Chiragadiga/Motion_Estimator_28nm/README.md

# Motion_Estimator_28nm
Design of RTL to GDS2 layout for ME with 15 FPS for 8 bit gray-scale coded pictures with Reference block of 16X16 px and search window of 32X32 px
