Chiragadiga/Motion_Estimator_28nm/readme.txt

You can find Attached the reports of the Design, Simulation, Physical Design in this folder

The clock period id 3.846 ns which is 1/260 Mega Hertz

All reports were added in the 'Reports' file but not in the project report and presentation  (Kindly consider)
 
The stimuli is in the .hex format

Physical Design in icc2 is conducted by creating a TOOL COMMAND LANGUAGE(tcl) file and are sourced with the required files
