Chiragadiga/Motion_Estimator_28nm/ENGR_852_Chirag.docx

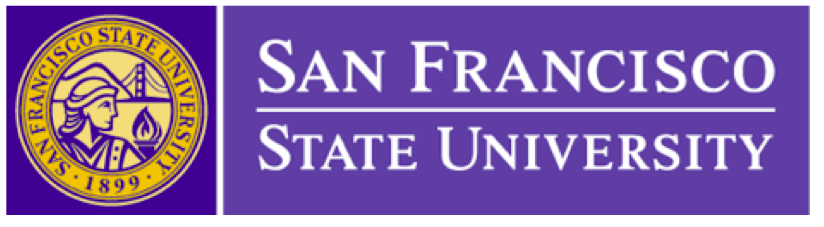
[picture p4: figure]

Final Project Report

on

ASIC Implementation of Motion Estimator in 32/28nm CMOS

Guided by Prof. Hamid Mahmoodi

Advanced Digital Design

Fall 2021

By:

Chirag C Adiga (922059109)

ACKNOWLEDGEMENT

Finishing the semester with this project report is an appropriate opportunity to express our gratitude to Dr. Hamid Mahmoodi for his invaluable guidance & support.

Without his incredible inputs, patience, excellent guidance and motivation at each and every step of the project we could not have completed this project.

A token of appreciation towards Lovpreet our teaching assistant who helped us at multiple occasions when we were confused about implementing the various concepts.

We are immensely grateful to our friends and classmates. They have supported and guided us at various stops and faults during the project.

Table of Contents

1. Understanding the Motion Estimator............................................................4
2. Design Specifications.....................................................................................6
3. Testbench for RTL verification......................................................................7
4. DC Synthesis................................................................................................11
5. Pre-Layout Timing Verification using Prime Time…….…………………18
6. Physical Design............................................................................................19
  a) Floor planning
  b) Placement
  c) Clock tree synthesis
  d) Routing
  e) Extraction
7. Post-Layout Timing Verification using Prime Time……..………….…….29
8. Results……………………………………………………………………..32
9. References…………………………………………………………………33

1. What is Motion Estimator

Motion estimation is the process of determining motion vectors that describe the transformation from one 2D image to another, usually from adjacent frames in a video sequence. Motion estimation is one of the key components of high compression video CODECS. The motion vectors may relate to the whole image (global motion estimation) or specific parts, such as rectangular blocks, arbitrary shaped patches or even per pixel (https://en.wikipedia.org/wiki/Pixel). The motion vectors may be represented by a translational model or many other models that can approximate the motion of a real video camera, such as rotation and translation in all three dimensions and zoom.

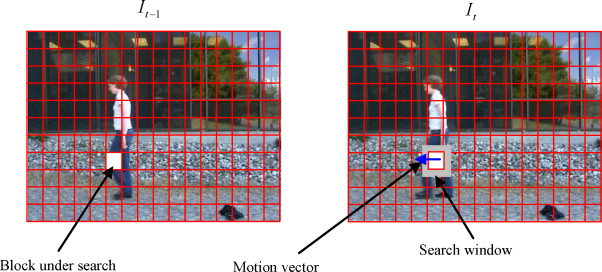
[picture p5: figure]

Fig 1: Concept of Motion Estimator

Figure 1 shows the concept of Motion Estimator, it illustrates a process of block-match algorithm. The most popular algorithm for motion estimation is block matching algorithm (BMA) due to simple hardware implementation. In a typical BMA, each frame is divided into blocks, each of which consists of luminance and chrominance blocks. Usually, for coding efficiency, motion estimation is performed only on the luminance block. The motion vector and the resulting error can be transmitted instead of the original luminance block; thus, interframe redundancy is removed and data compression is achieved. At receiver end, the decoder builds the frame difference signal from the received data and adds it to the reconstructed reference frames. The summation gives an exact replica of the current frame. The better the prediction the smaller the error signal and hence the transmission bit rate.

2.Design Specifications

The goal of the design is to achieve the following specifications:

- The design is expected to meet the speed of 15 frames per second.
- The picture is gray-scale coded (8 bits per block).
- The reference block is 16x16 pixels and the search window is 32x32 pixels. There are 4096 reference blocks in a frame.
- To minimize the total area and energy consumed by the logic over the entire simulation of the test set.
- Must operate at the speed given above.

Verification Plan:

Several test benches will be developed with known motion vectors as well as random stimulus. These test benches will be applied to the design and the results will be compared against expected outcomes. The expected outcomes will be produced using a reference model or manually and compared against the outcomes produced by the design under test.

Design Plan:

After verification of the RTL code, the design is taken to the ASIC flow starting with front-end synthesis and timing check, followed by back-end physical design involving placement, clock-tree synthesis, and routing. The parasitics will be extracted from layout for final timing check using primetime. Efforts will be made to improve the design in terms of power consumption and area, while meeting the timing.

3. Test Bench Verification

Test bench provides the top-level design that stimulus the design. It is an environment in which the product under development is tested with the help of software and hardware tools. Individual modules were verified first by separate testbenches. Then a to-level test bench was implemented to verify the overall functioning of the complete design.

Verification scripts

source /packages/synopsys/setup/synopsys_setup.tcl

Verification of Processing Element module: Arbitrary inputs were assigned within the testbench to inputs and observe the generated outputs. The idea was to verify the logical functioning of the S1S2mux signal such that it selects value S2 rather than S1 on active high signal. Also, arithmetic correctness of the accumulate signal is verified through waveforms.

- For PE verification:

vcs –V –R –full64 PE_tb.v PE.v –debug_pp –o simv –gui

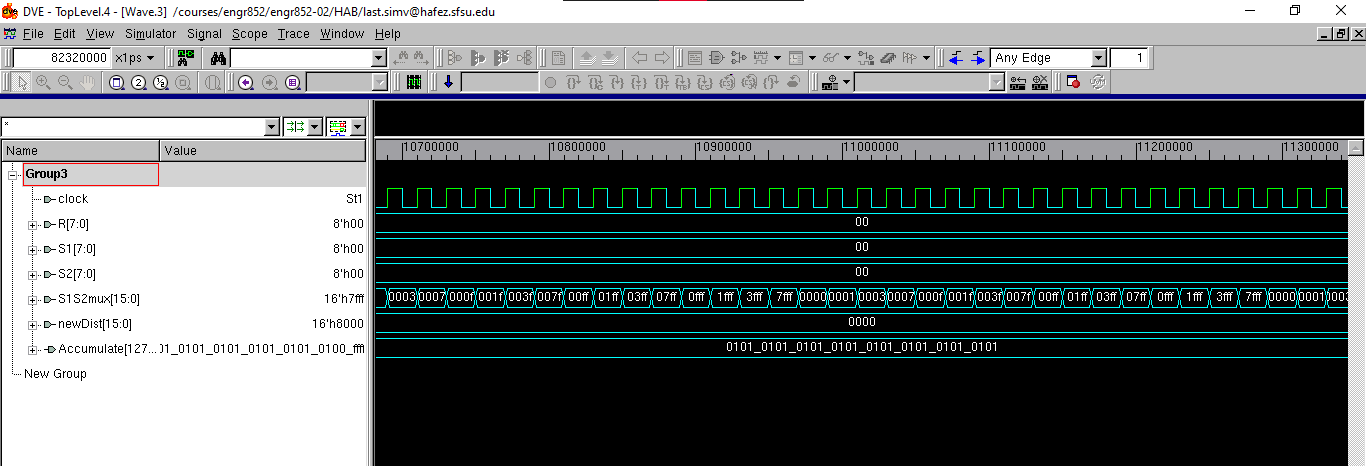
[picture p6: figure]

Fig 2: Simulation Results of Processing Element

Verification of Control Unit: The control implemented a counter to generate control signals and the value of these signals were dependent on count register of the control unit. The testbench simply initializes the control unit through a start signal and then monitors the generated signals. The generated signals were observed in the waveforms and the values for all the control signals were as desired.

- For control module verification:

vcs –V –R –full64 ctrl_tb.v control.v –debug_pp –o simv –gui

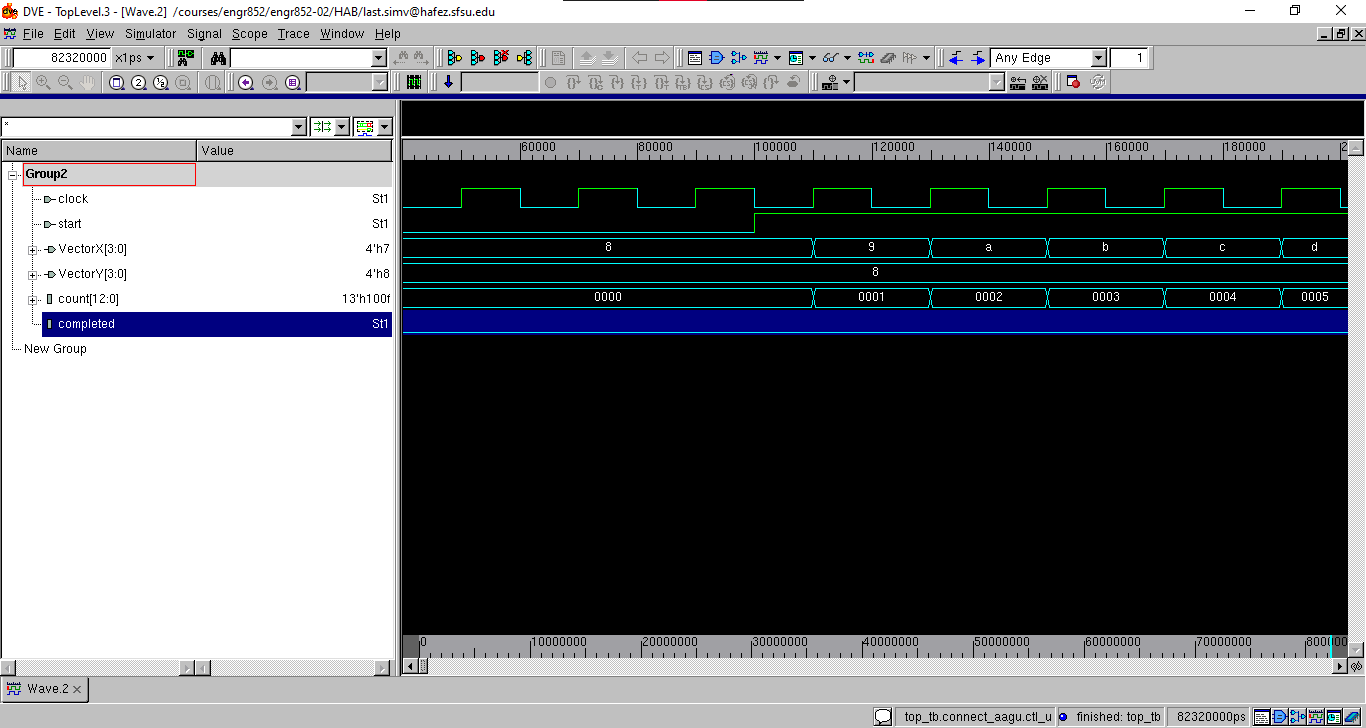
[picture p7: figure]

Fig 3: Simulation Results of Control Unit

Verification of Comparator Unit: The testbench loads PEout register is loaded with and arbitrary value and then random PEready signals, VectorX, VectorY values are applied by testbench to imitate an input of the PE and Control unit. The idea is to observe the BestDist values and Motion vectors are generated as desired from these input vectors. The values observed in waveforms verified the logical functioning of the comparator unit as the intended values were recorded.

- For comparator module verification:

vcs –V –R –full64 comp_tb.v comp.v –debug_pp –o simv –gui


Fig 4: Simulation Results of Comparator

Verification of top level testbench:

Top test bench is connected to the top module of RTL and is providing the Reference and Search values to the RTL by reading external .txt files. The first reference value is set to ‘1’ and all other values are set to 0 while search values are all set to ‘0’. The intention is to produce a distortion for initial values which the comparator will output as best distortion value once the CompStart signal goes high and updates the motionX and motionY values as (-8,8).

Since the distortion occurs at first value, the reference window will be at the top left corner of the search window, so the motion for X= -8 and Y =8 should be observed in waveforms. The observed values of motionX in waveforms is 8 and it is a 2’s complement value of (-8). The initial VectorX values from the control RTL are 2’s complement of (-8, -7, -6, -5, -4, -3, -2, -1) as (8, 9, a, b, c, d, e, f, ) when compared with the VectorX expression in control RTL ( these values can be observed in control unit testbench waveforms while verification of control module). Since the motionX value is directly latched from the values of VectorX within the comparator, it verifies the motionX value ‘8’ in waveforms is a 2’s complement of ‘-8’.

The intended values for motion vectors were observed as outputs to verify that the design generates correct motion values for the least distortion observed during overlays.

- For top level verification:

vcs –V –R –full64 top_tb.v rtl.v –debug_pp –o simv –gui


Fig 5: Simulation Results of Top Level Test bench

# 4. DC Synthesis

Design Compiler is a synthesis tool that synthesizes RTL [Register Transfer Logic] hardware description (Verilog/VHDL) which has a standard cell of library as input which provides output of a gate-level-netlist. Gate-level-netlist is a structural representation of standard cells based in the standard cell library.

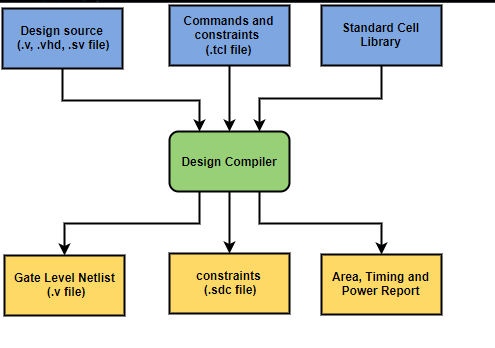
[picture p8: figure]

Fig 6: Synthesis Flow

The design on synthesis gave a negative slack for set-up time approx. 3.04 in magnitude. The issue was significant since the value was almost equal to clock frequency. The issue was resolved by using LVT cells for the design working in ff (fast-fast) configuration. The post synthesis set-up time was reported with a slack of 2.95 after the implementation of LVT cells in the design.

Synthesis scripts

dc_shell –xg –t

lappend search_path path of RTL

define_design_lib WORK –path “work”

source ../../../../lib_setup.tcl

options selected [yes (multi-threshold design), ccs, lvt, ff]

source …/…/…/../lib_container.tcl

analyze –library WORK –format Verilog rtl.v

elaborate –architecture Verilog –library WORK Switch

create_clock clock –name ideal_clock1 –period 3.846

compile –incremental

write_sdc estimator.sdc

write –f ddc –hierarchy –output estimator.ddc

report_area > reports/estimator_area.rpt

report_cell > reports/estimator_cell.rpt

report_design > reports/estimator_design.rpt

report_power > reports/estimator_synthesis_power.rpt

report_timing > reports/estimator_synthesis_timing.rpt

report_timing –delay min > reports/estimator_synthesis_hold.rpt

DC synthesis Timing Report:

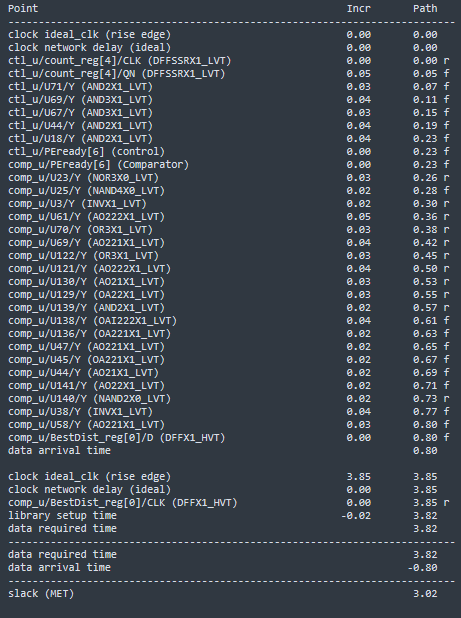
[picture p9: figure]

Fig 7 : Maximum Timing Report ( Post Synthesis)

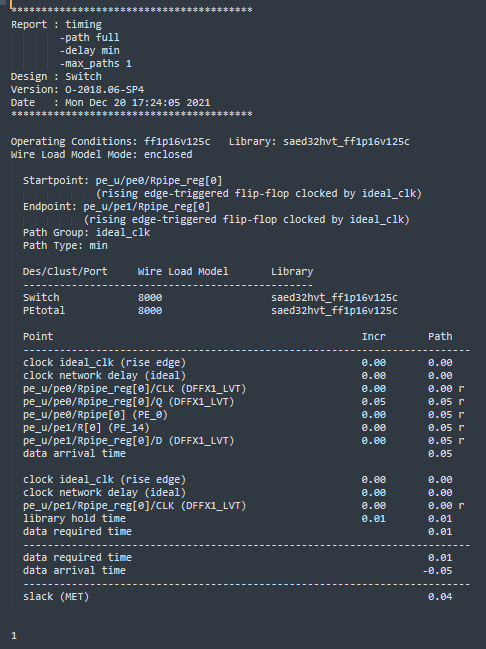
[picture p10: figure]

Fig 8: Minimum Timing Slack Report ( Post Synthesis)

Reports of Area Post Synthesis:

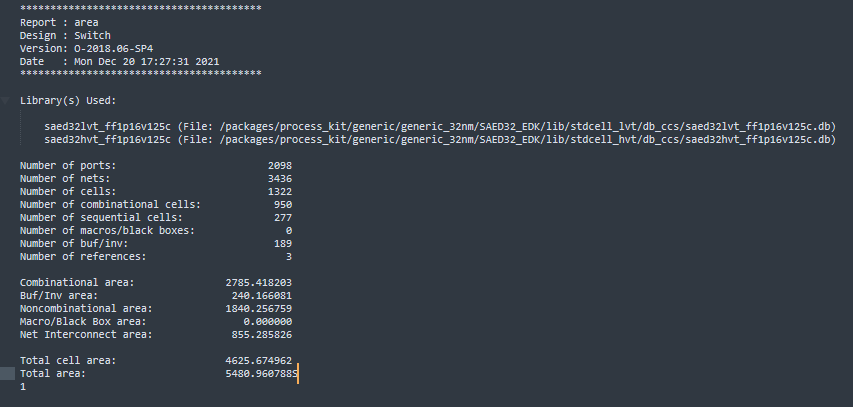
[picture p11: figure]

Fig 9. Total Area

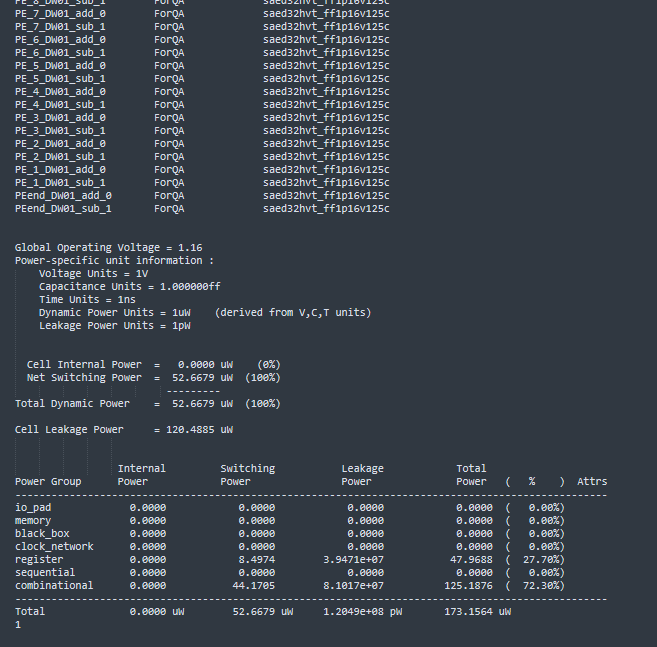
[picture p12: figure]

Fig 10: Post Synthesis Power report

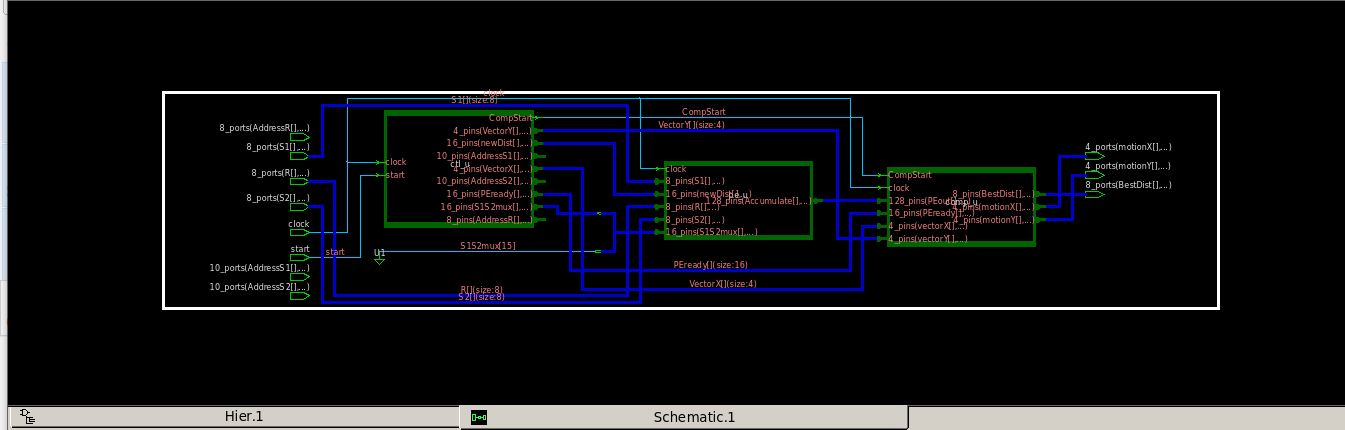
[picture p13: figure]

Fig 11: Schematic post synthesis

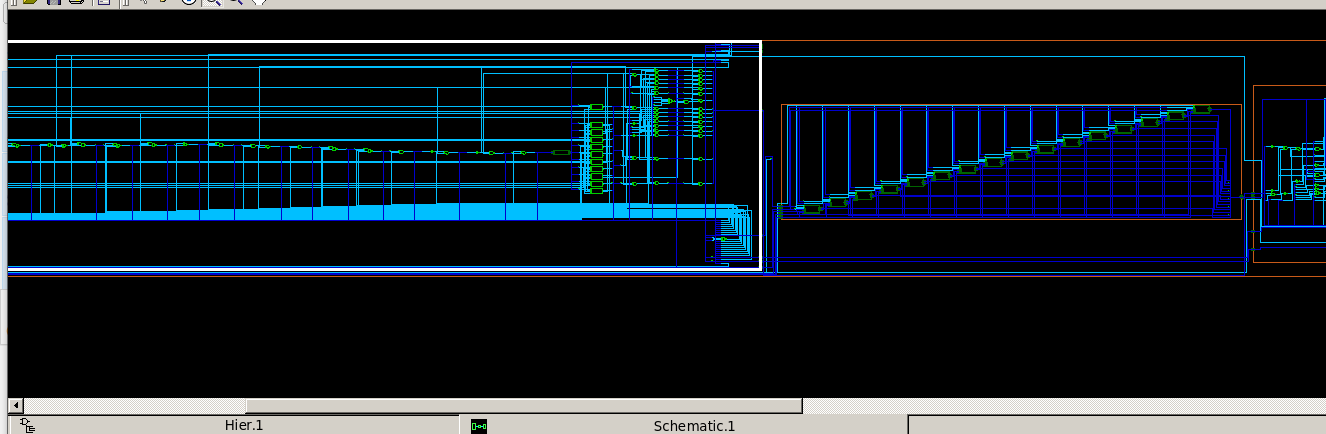
[picture p14: figure]

Fig 12: Schematic of Control unit and PE

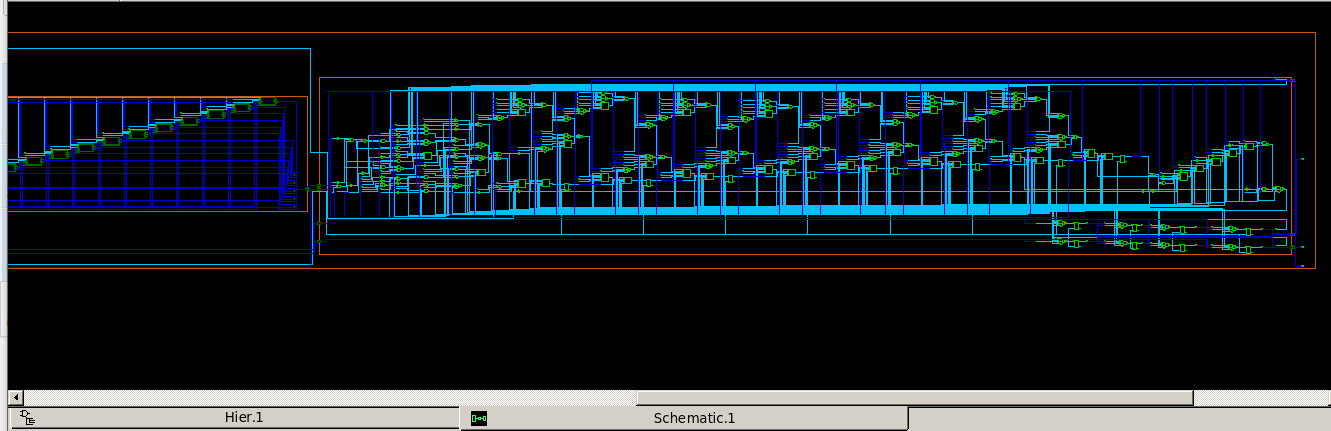
[picture p15: figure]

Fig 13: Comparator Schematic

# 5. Pre-Layout Verification using Prime Time

Pre-Layout PrimeTime Script:

This step is performed for an added confirmation of the slack /

pt_shell

source …/…/…/../lib_container.tcl

read_verilog ../../../estimator_net.v

current_design Switch

link_design

source ../../../estimator.sdc

report_timimg (setup)

report_timing –delay_type min (hold)

6. Physical Design:

In Physical design the circuit description is transformed into a physical design where the position of the cell is described and routes for the interconnection between them. ASIC physical design is a part where the design meets the physical world and constraints are added. Below is detailed flowchart of ASIC flow which consists of Initialization, Floorplanning, Placement, Clock Tress Synthesis, Routing and Extraction.

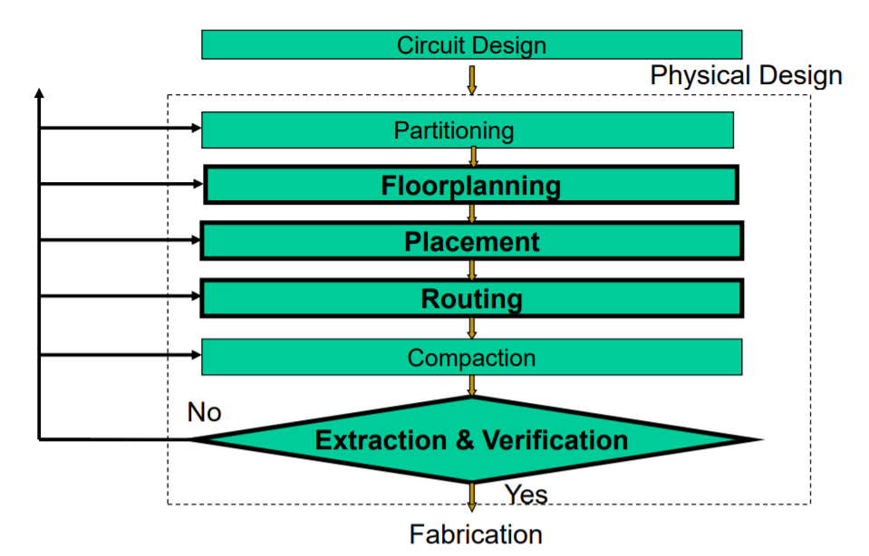
[picture p16: figure]

Fig 14: Physical Design Flow Chart

The designing in GUI is more educating, due to availability of multiple options such as view by hierarchy, view by color at the placement, CTS and routing steps of the design flow. These options help us to visually understand the cell placement and wiring connections of various modules.

Physical Design Scripts

Initial environment setup

icc_shell

gui_start

set mw_logic0_net VSS

set mw_logic1_net VDD

set_tlu_plus_files -max_tluplus /packages/process_kit/generic/generic_32nm/SAED32_EDK/tech/star_rcxt/saed32nm_1p9m_Cmax.tluplus -min_tluplus /packages/process_kit/generic/generic_32nm/SAED32_EDK/tech/star_rcxt/saed32nm_1p9m_Cmin.tluplus -tech2itf_map /packages/process_kit/generic/generic_32nm/SAED32_EDK/tech/star_rcxt/saed32nm_tf_itf_tluplus.mp

create_mw_lib -technology /packages/process_kit/generic/generic_32nm/SAED32_EDK/tech/milkyway/saed32nm_1p9m_mw.tf -mw_reference_library {/packages/process_kit/generic/generic_32nm/EDK_updated_april2012/SAED32_EDK/lib/stdcell_lvt/milkyway/saed32nm_lvt_1p9m} estimator_design.mw

open_mw_lib estimator_design.mw

read_verilog ../../output/estimator_net.v

uniquify_fp_mw_cel

link

read_sdc ../…/…/estimator.sdc

save_mw_cel –as estimator_inital_design_setup

Floor planning

At the stage of floor planning, we have the netlist that describes design and interconnection between different blocks. It defines the I/O ports, power supply connections. The final timing, quality of the chip depends on the floorplan design.

Script for Floor planning:

create_floorplan -core_utilization 0.6 -start_first_row -left_io2core 5.0 -bottom_io2core 5.0 -right_io2core 5.0 -top_io2core 5.0

derive_pg_connection -power_net VDD –ground_net VSS

derive_pg_connection -power_net VDD –ground_net VSS –tie

//Create VSS ring

create_rectangular_rings -nets {VSS} -left_offset 0.5 -left_segment_layer M6 -left_segment_width 1.0 -extend_ll -extend_lh -right_offset 0.5 -right_segment_layer M6 -right_segment_width 1.0 -extend_rl -extend_rh -bottom_offset 0.5 -bottom_segment_layer M7 -bottom_segment_width 1.0 -extend_bl -extend_bh -top_offset 0.5 -top_segment_layer M7 -top_segment_width 1.0 -extend_tl -extend_th

// Create VDD Ring

create_rectangular_rings -nets {VDD} -left_offset 1.8 -left_segment_layer M6 -left_segment_width 1.0 -extend_ll -extend_lh -right_offset 1.8 -right_segment_layer M6 -right_segment_width 1.0 -extend_rl -extend_rh -bottom_offset 1.8 -bottom_segment_layer M7 -bottom_segment_width 1.0 -extend_bl -extend_bh -top_offset 1.8 -top_segment_layer M7 -top_segment_width 1.0 -extend_tl -extend_th

create_power_strap -nets { VDD } -layer M6 -direction vertical -width 3

create_power_strap -nets { VSS } -layer M6 -direction vertical -width 3

save_mw_cel –as estimator_floorplan

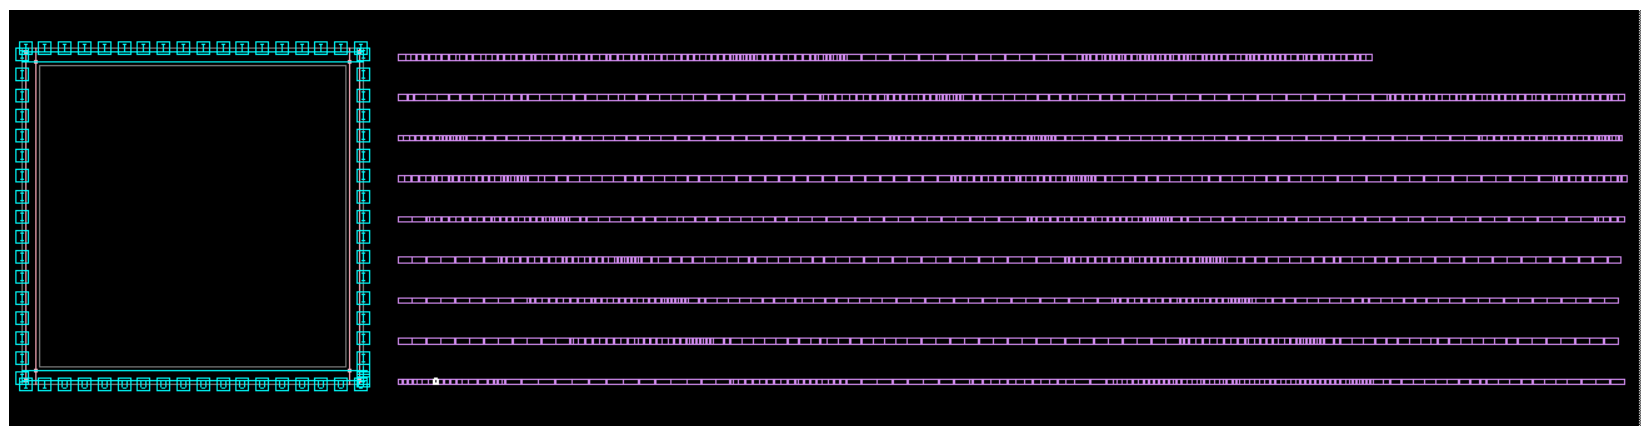
[picture p17: figure]

Fig 15: Floor Planning

Placement

The standard cell locations are defined to a particular position in a row. It is a process of placing the design cells in the floorplan in the most optimal way. The main algorithm is to make the chip as dense as possible. To minimize the total wire length. The number horizontal/vertical wire segments crossing a line.

Scripts for Placement:

set_buffer_opt_strategy -effort low

set_tlu_plus_files -max_tluplus /packages/process_kit/generic/generic_32nm/SAED32_EDK/tech/star_rcxt/saed32nm_1p9m_Cmax.tluplus -min_tluplus /packages/process_kit/generic/generic_32nm/SAED32_EDK/tech/star_rcxt/saed32nm_1p9m_Cmin.tluplus -tech2itf_map /packages/process_kit/generic/generic_32nm/SAED32_EDK/tech/star_rcxt/saed32nm_tf_itf_tluplus.map

place_opt –congestion

report_placement_utilization > reports/estimator_place_utilization.rpt

report_timing -delay max -max_paths 1 > reports/estimator_placement.setup_time.rpt

report_timing -delay min -max_paths 1 > reports/estimator_placement.hold_time.rpt

save_mw_cel -as estimator_placement

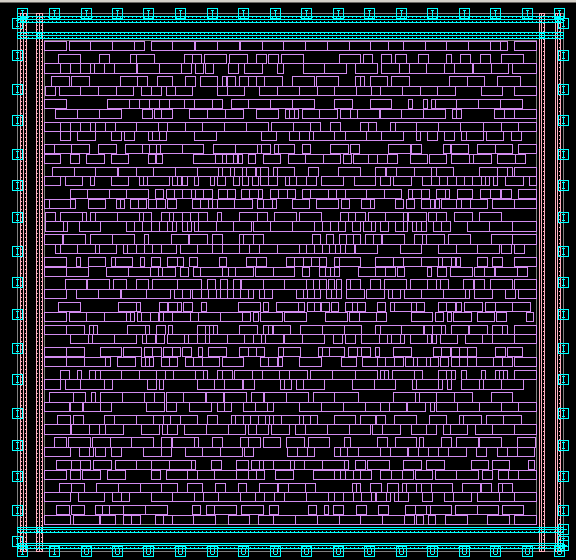
[picture p18: figure]

Fig 16: Placement

Clock Tree Synthesis:

CTS is a process which makes sure that the clock gets distributed evenly to all sequential elements in a design. During this process, depending on the clock skew, buffers are added to the different clock paths in the design. More delays (buffers) are added on the launching side to have a better hold time. More delays (buffers) are added to latching side to have a better Set up time.

Clock Tree Synthesis Scripts

Clock > Core CTS and Optimization action in GUI.

report_timing -delay max -max_paths 1 > reports/estimator_cts.setup.rpt

report_timing -delay min -max_paths 1 > reports/estimator_cts.hold.rpt

save_mw_cel –as estimator_cts

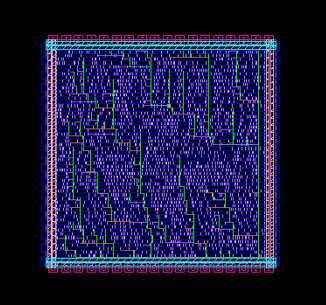
[picture p19: figure]

Figure 17: Clock Tree Synthesis

Routing

After the floor planning and placement steps in the design, routing needs to be done. Routing is the process of connecting the various blocks in the chip with one another.

Routing Scripts:

Route > Core Routing and Optimization action in GUI.

report_placement_utilization > reports/estimator_route_utilization.rpt

report_timing -delay max -max_paths 1 > reports/estimator_route.setup.rpt

report_timing -delay min -max_paths 1 > reports/estimator_route.hold.rpt

save_mw_cel –as estimator_route

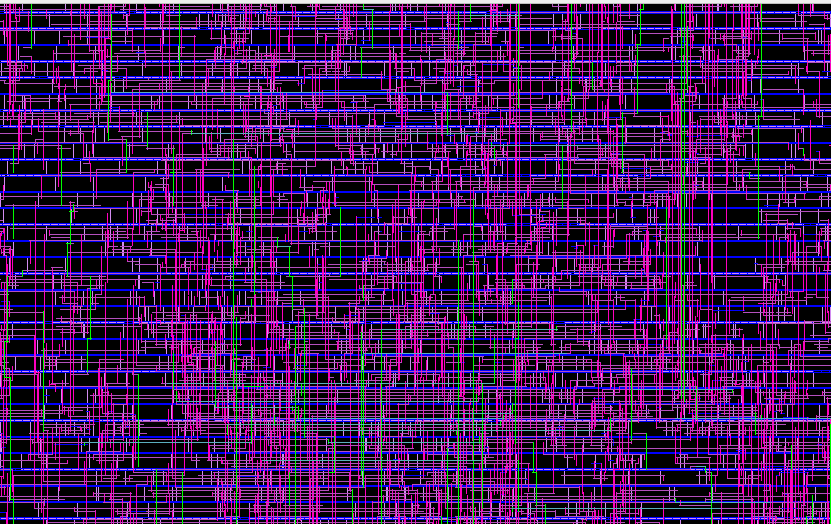
[picture p20: figure]

Figure 18 . Routing

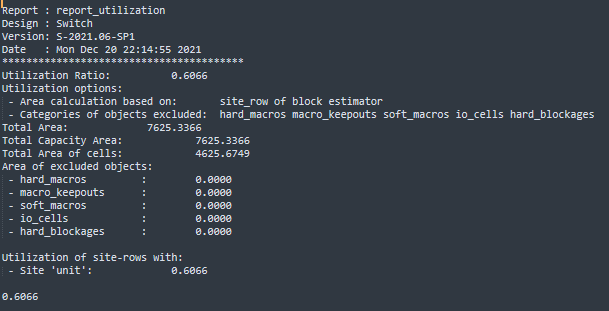
[picture p21: figure]

Fig 19: Utilization Report

Extraction:

Extraction is generating RC parasitics post routing and generating a new netlist. All layouts can extract the layout database using various algorithms and these algorithms define the accuracy of extracted values.

Extraction Scripts:

extract_rc -cou

pling_cap -routed_nets_only -incremental

write_parasitics -output ./outputs/estimator_extracted.spef -format SPEF

write_sdf ./outputs/estimator_extracted.sdf

write_sdc ./outputs/estimator_extracted.sdc

write_verilog ./outputs/estimator_extracted_net.v

report_timing -delay max -max_paths 1 > reports/estimator_extraction.setup.rpt

report_timing -delay min -max_paths 1 > reports/estimator_extraction.hold.rpt

report_power > reports/estimator_extracted_power.rpt

save_mw_cel –as estimator_extracted

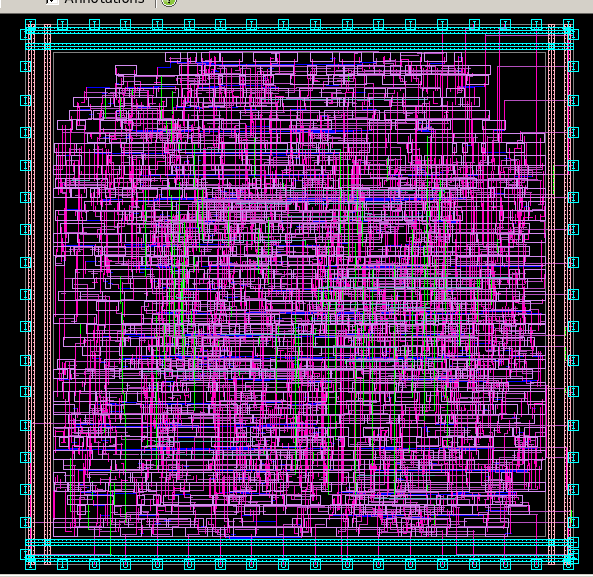
[picture p22: figure]

Fig 20: Placement of Cell in Different Colors

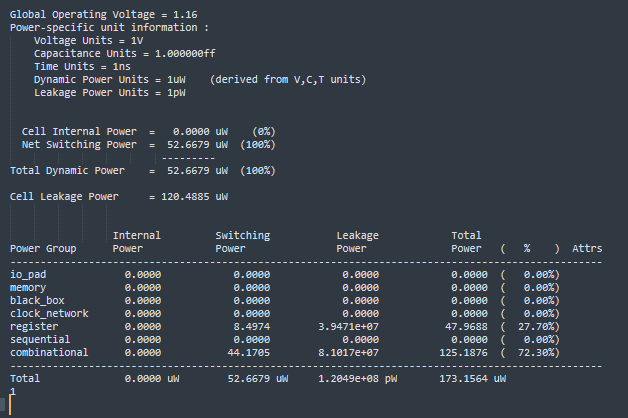
[picture p23: figure]

Fig 21: Power report after extraction

7. Post Layout Timing Reports (Prime Time):

To perform timing verification on the extracted netlist we run primetime. We use the post level netlist as well as parasitic information at this stage.

Primetime verification post layout presented challenges in analysis due to unresolved links between cells and reference library. We need to figure out the sourcing and linking appropriately of the required files. Out of the four available modes for the STA, check carried out in mode of primary inputs to primary outputs.

Post-Layout Primetime Scripts:

pt_shell

source …/…/…/../lib_container.tcl

read_verilog ../../../estimator_extracted_net.v

current_design Switch

FOR SETUP

read_parasitics -format SPEF ../../outputs/estimator_extracted.spef.max

read_sdc ../../estimator_extracted.sdc

report_timing -from [all_inputs] -to [all_outputs] -max_paths 1 > reports/ timing_setup.pt_postlayout.rpt

FOR HOLD

read_parasitics -format SPEF ../../outputs/estimator_extracted.spef.min

read_sdc ../../estimator_extracted.sdc

report_timing -from [all_inputs] -to [all_outputs] -max_paths 1 -delay_type min > reports/ timing_hold.pt_postlayout.rpt

Post-Physical Design Timing Reports:

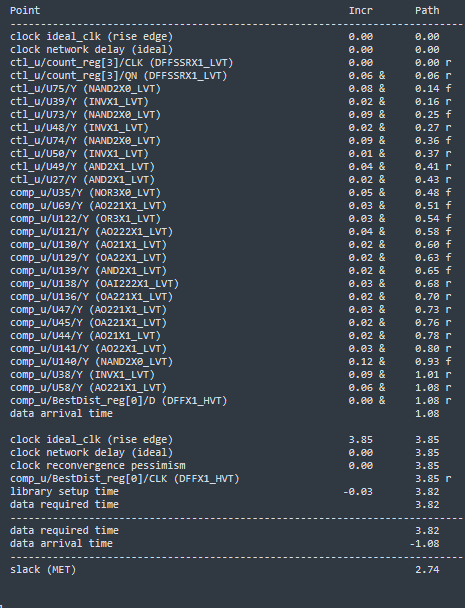
[picture p24: figure]

Fig 22: Maximum Timing Report (PD)

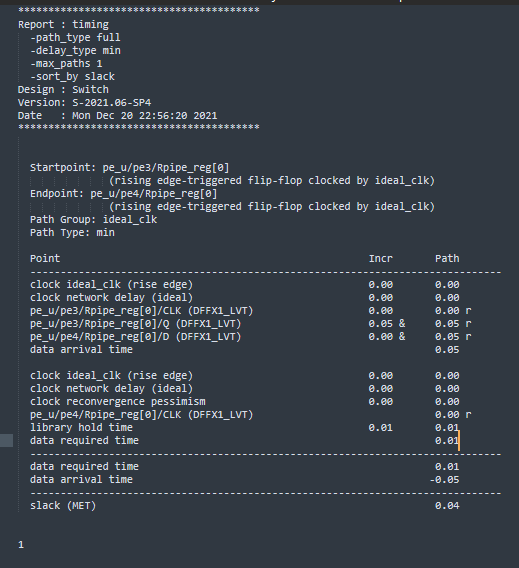
[picture p25: figure]

Fig 23: Minimum Timing Report (PD)

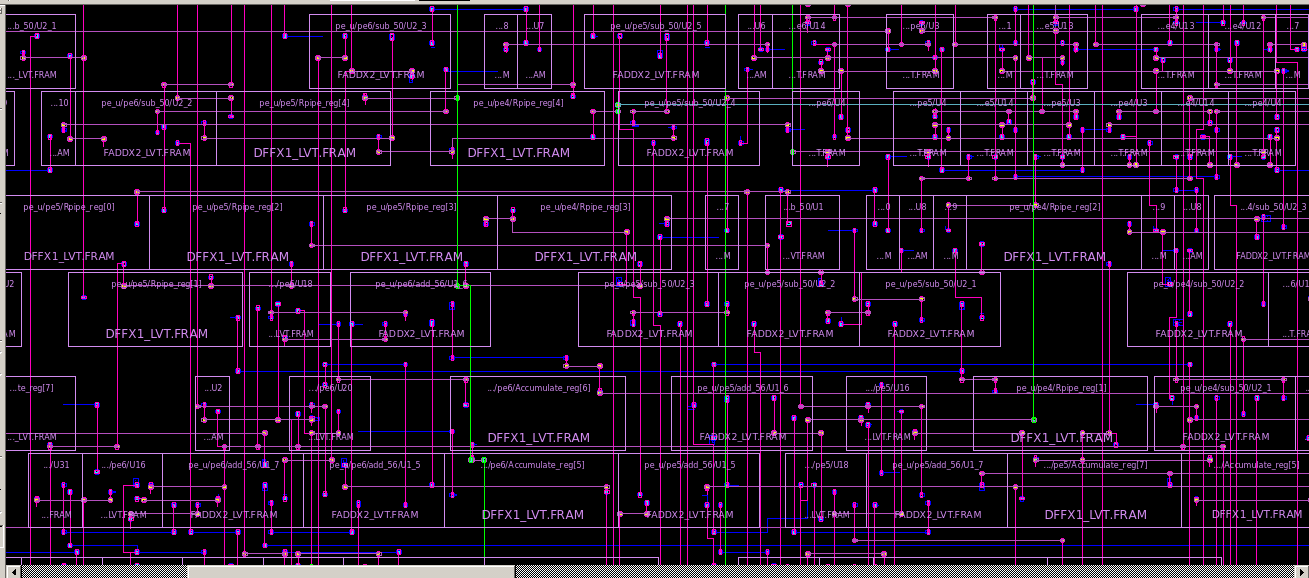
[picture p26: figure]

Fig 24: Final Layout

Results

Having completed the ASIC flow from RTL to GDS, We Verified the design by simulation.

We have met the timing for both setup and hold in post layout timing verification.

We have optimized the Area and Power.

Total Area: 5480.9607 um² (after synthesis)

Cell leakage Power: 147.3350 uW (after synthesis)

Dynamic Power: 52.0520 uW (after synthesis)

Total Power: 173.1546 uW (after synthesis)

Chip Area: 9471.817 um² (post pnr)

Cell leakage Power: 1.16e+08 pW (post layout and extraction)

Dynamic Power: 2.91e+07 pW (post layout and extraction)

Total Power: 210.2477 uW (post layout and extraction)

Set up time violations: No setup time violations in post layout timing analysis and have a slack value of (2.74).

Hold Time violations: No hold time violations in post layout timing analysis with slack value of (0.04).

References

[1] M. E. Rizkalla, et. al. “Hardware Implementation of Block-based Motion Estimation for Real Time Applications,” Journal of VLSI Signal Processing, pp. 139-159, 2007

[2] R. Meagher, et. al, “VHDL Design for Real Time Motion Estimation Video Applications,” Journal of Signal Processing Systems, Oct. 2008

[3] S. Lee, J. Kim, and S. Chae, “New motion estimation algorithm using adaptively quantized low bit-resolution image and its VLSI architecture for MPEG2 video encoding,” IEEE Transactions on Circuits and Systems for Video Technology, vol.8, no. 6, pp. 734-744, 1998

[4] Engr852 Lecture Notes from Professor Hamid Mahmoodi
