Chiragadiga/Motion_Estimator_28nm/Estimator.pdf

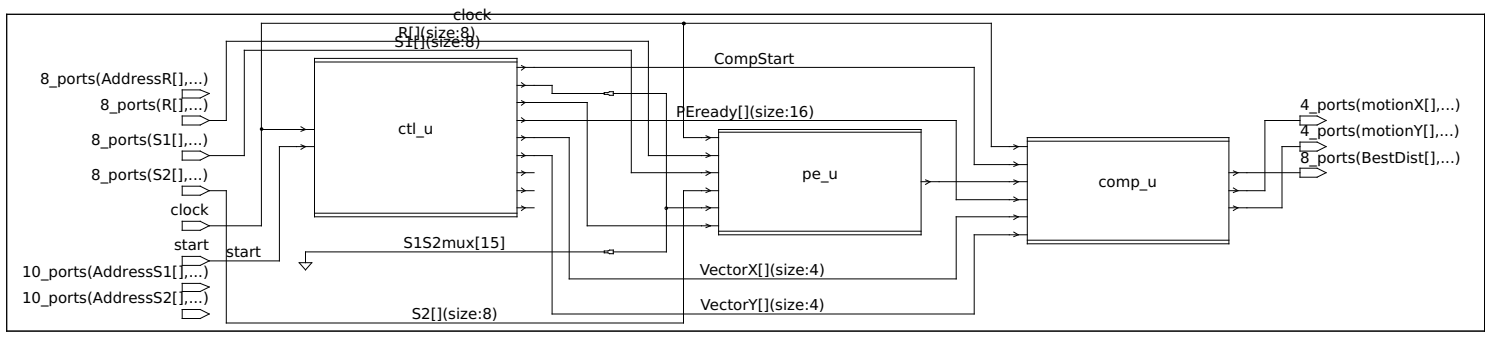
[picture p27: figure]
clo; 5] R[](size:8) S1[](size:8) S2[](size:8); E r e a d y[](siz e:1; Dis; t[],...) 4_ports(motionY[],...) 4_ports(motionX[],...)

6) VectorX[](size:4) VectorY[](size:4) clock start
R[],...) 8_ports(S1[],...) 8_ports(R[],...) 8_ports(S2[],...) 10_ports(AddressS2[],...) 10_ports(AddressS1[],...) | 8
