Chiragadiga/Motion_Estimator_28nm/Simulation_final.png

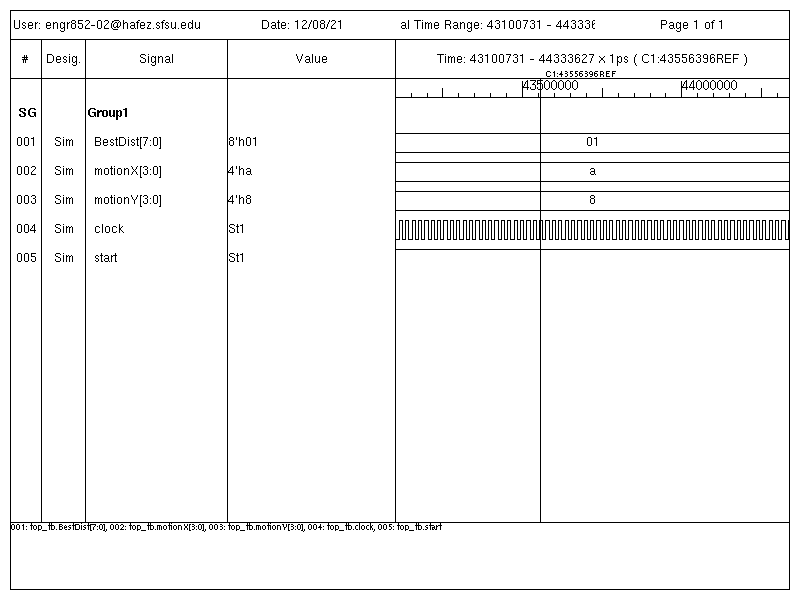
Simulation_final.png
