Chiragadiga/Motion_Estimator_28nm/Comparator.pdf

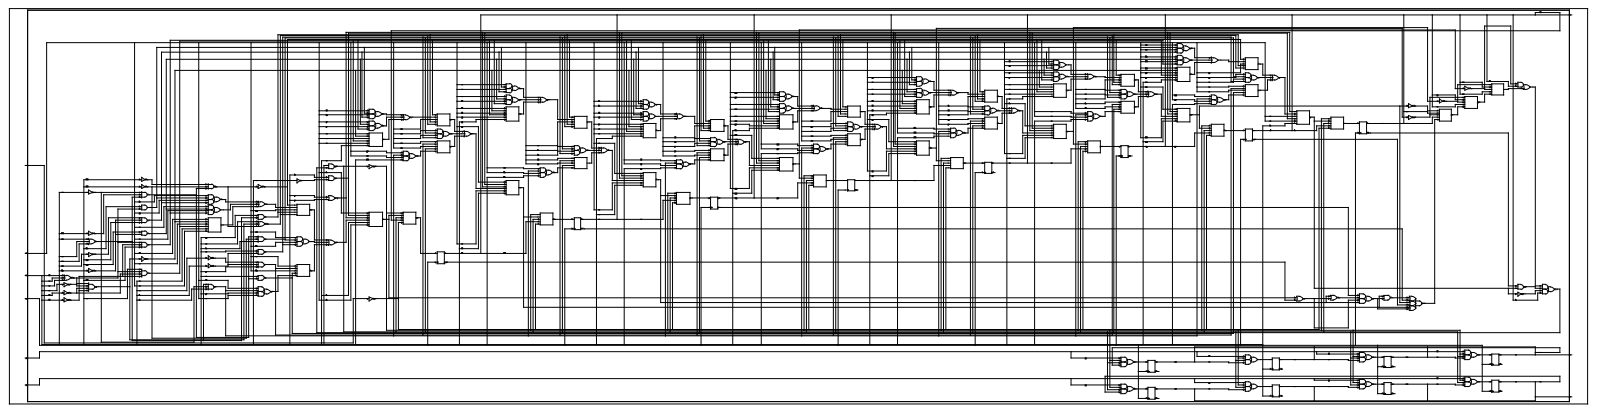
[picture p29: page 1]
