Chiragadiga/Motion_Estimator_28nm/Controller.pdf

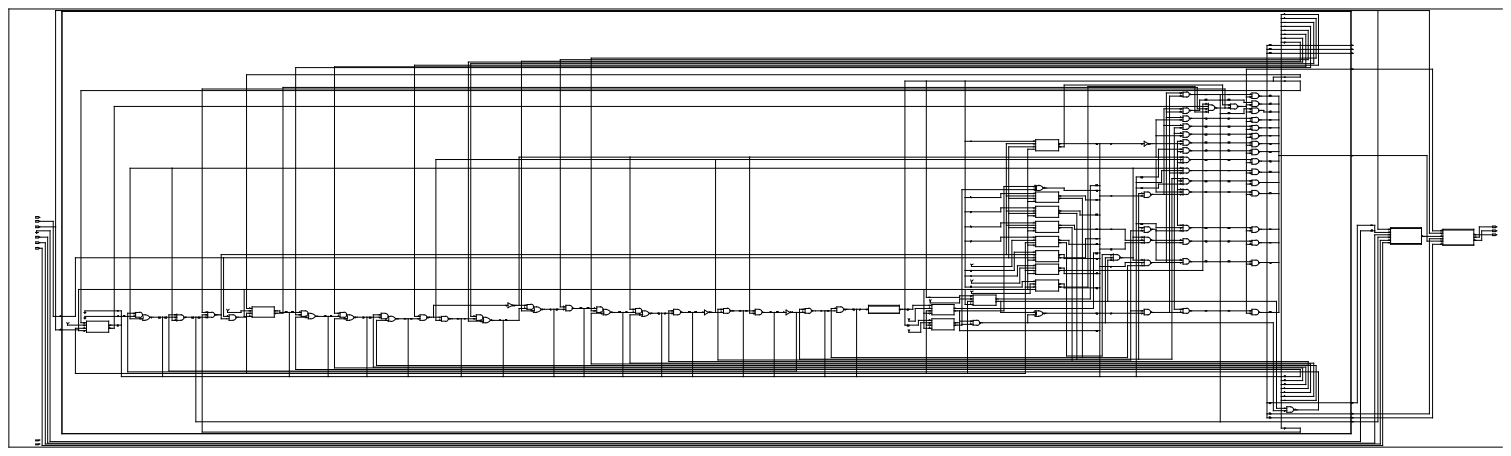
[picture p30: page 1]
