Chiragadiga/Motion_Estimator_28nm/dc_max_timing.pdf

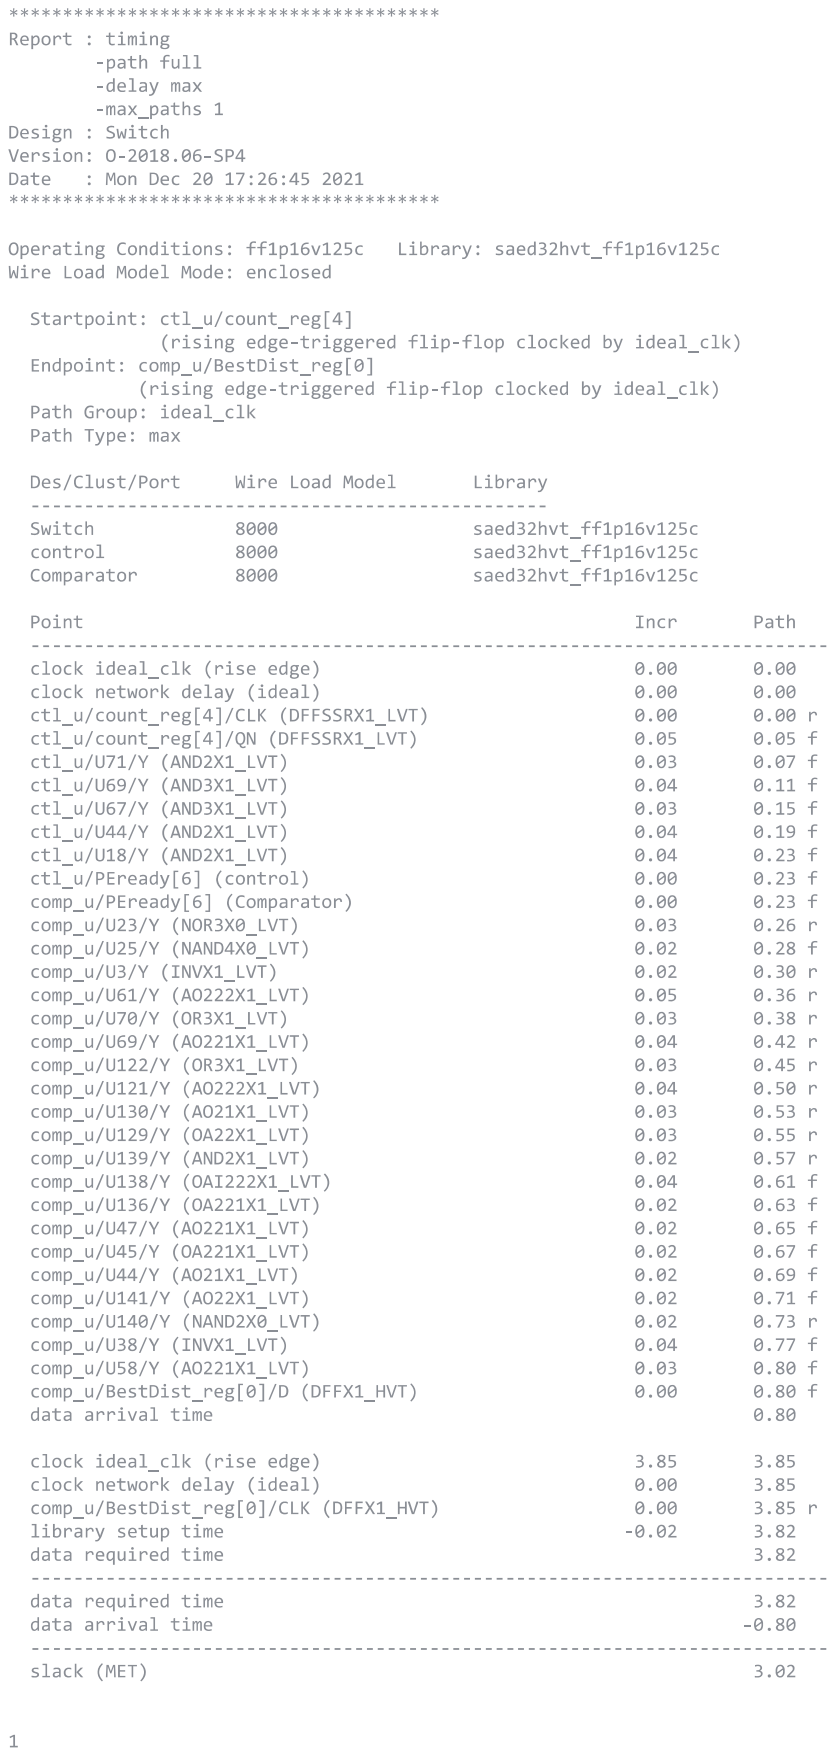
[picture p31: page 1]
