Chiragadiga/Motion_Estimator_28nm/dc_min_timing.pdf

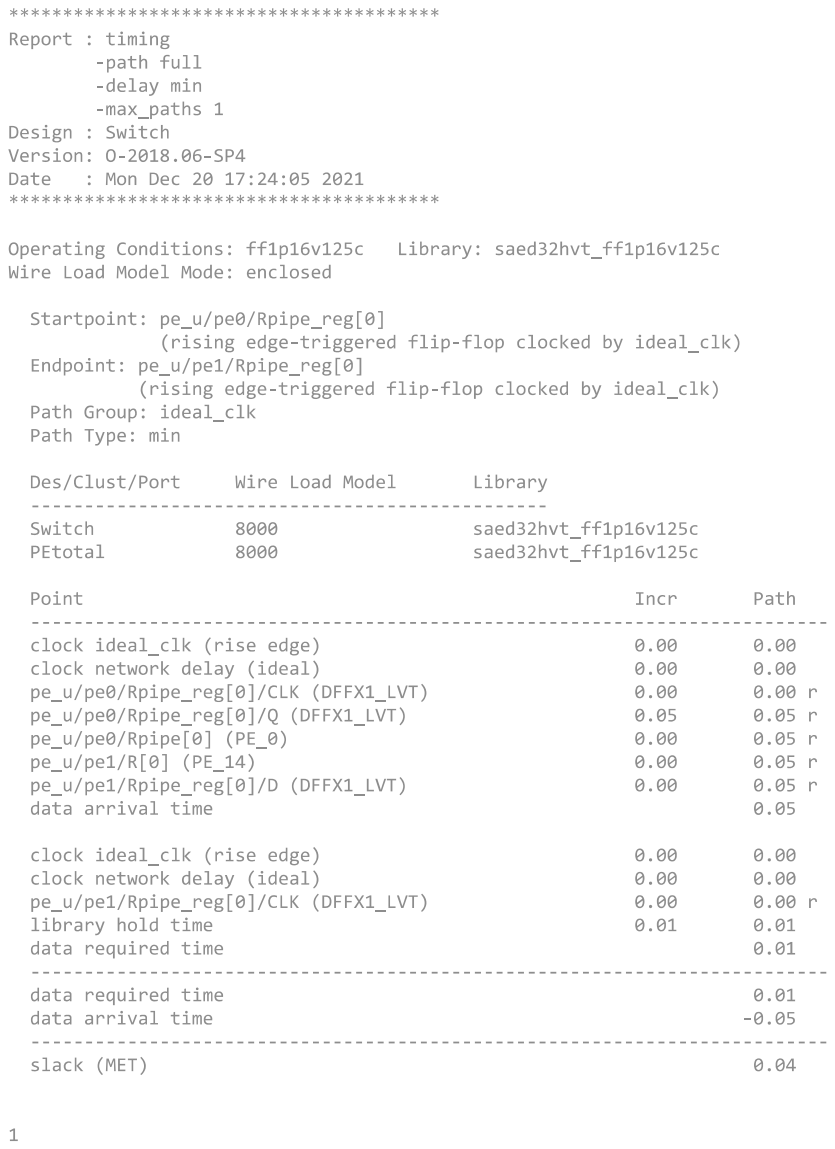
[picture p32: page 1]
