Chiragadiga/Motion_Estimator_28nm/PE.pdf

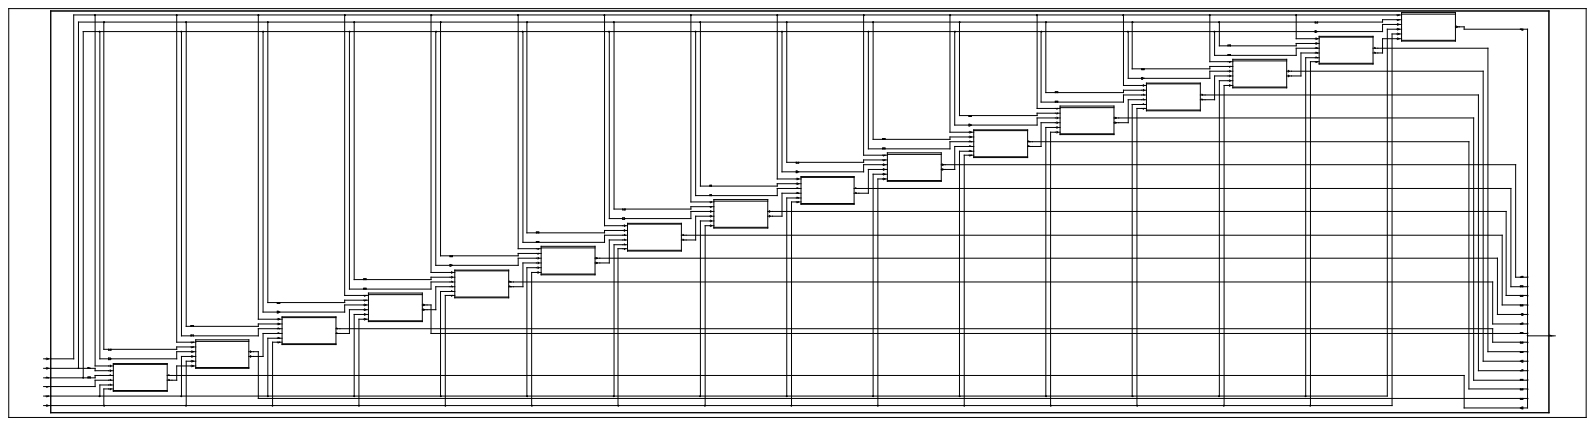
[picture p33: page 1]
